dl1bz/ESP32-XPA125B-HL2/ESP32-XPA125B-HL2-Schematic.pdf

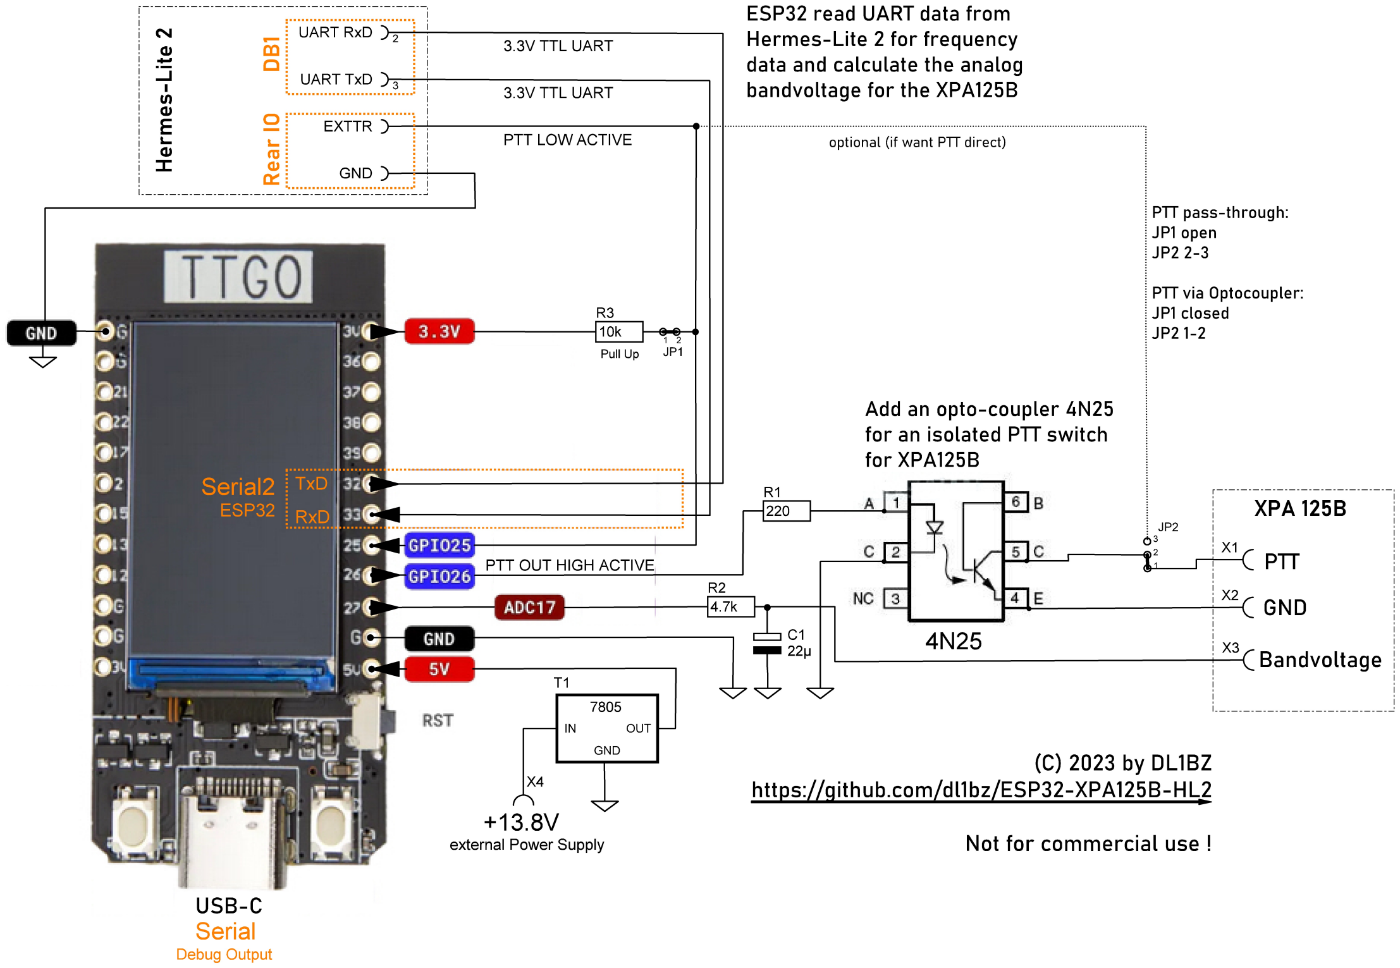
[picture p3: page 1]
